Bani-G/Bani_BlueStampPortfolio/CraneRemote.pdf

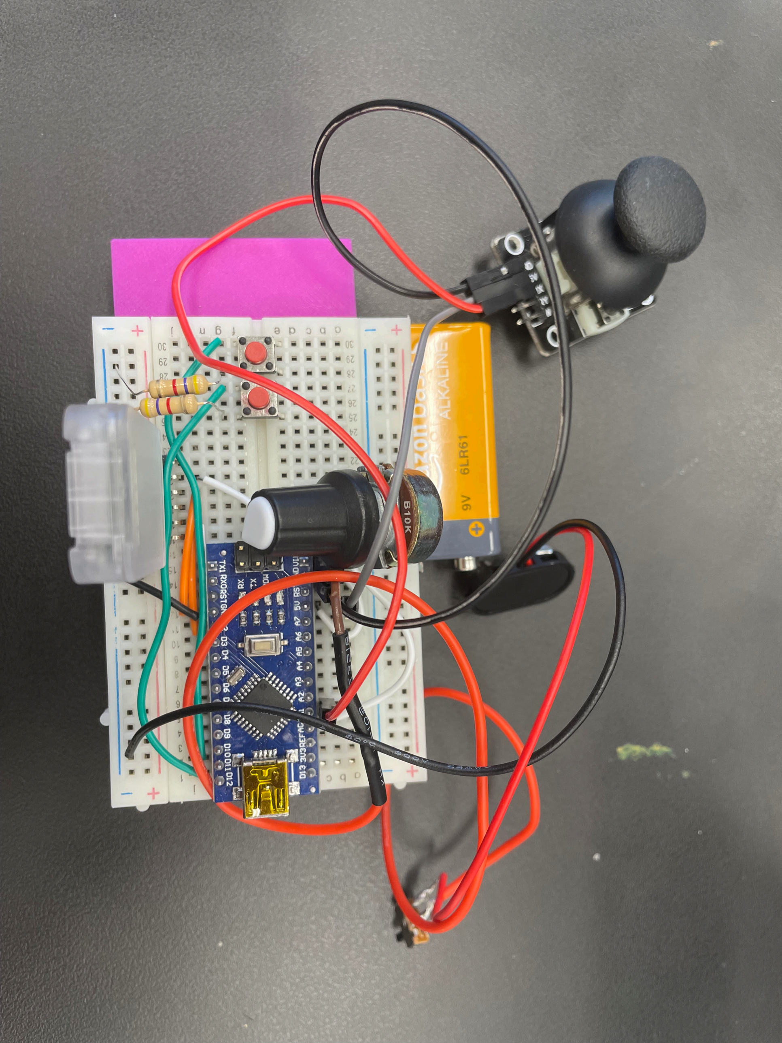
[picture p13: page 1]
