Bani-G/Bani_BlueStampPortfolio/CraneSchematics.png

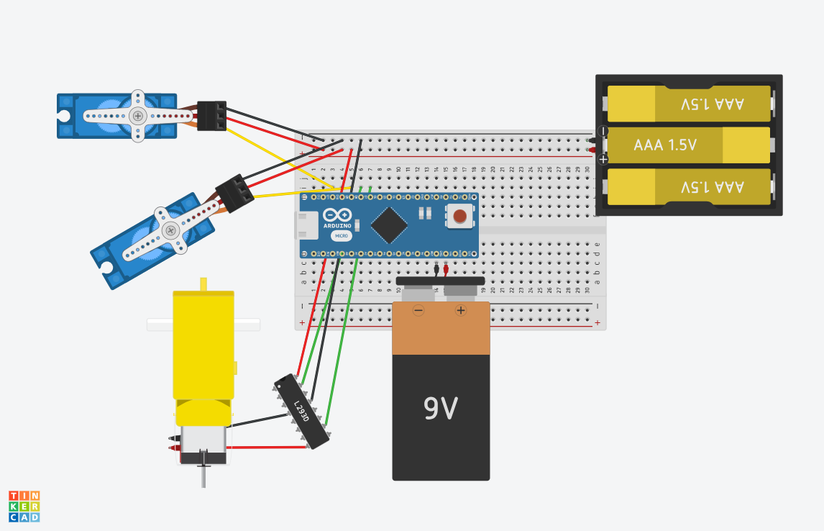
CraneSchematics.png
