Bani-G/Bani_BlueStampPortfolio/Flowchart.png

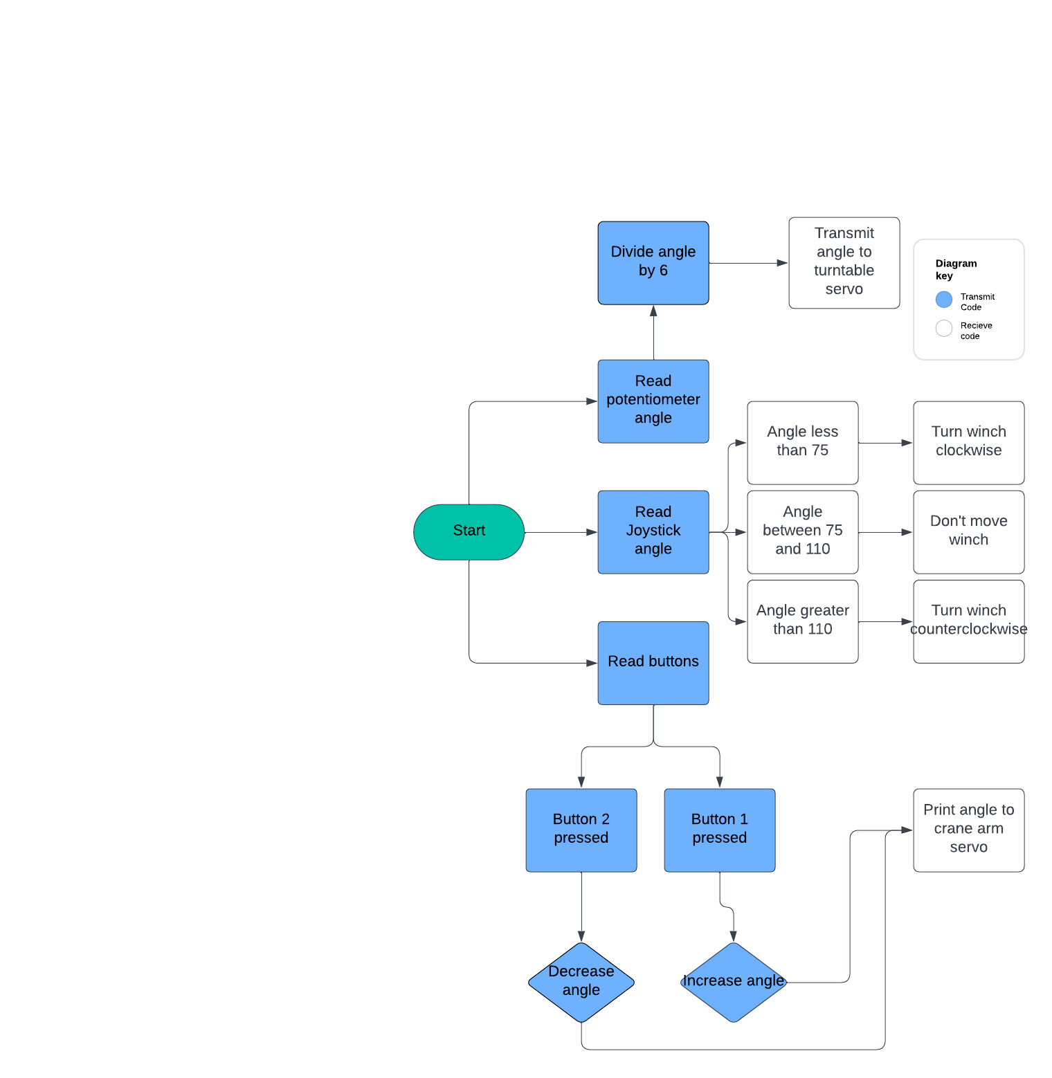
Flowchart.png
