Bani-G/Bani_BlueStampPortfolio/DCMotorMountV2.stl

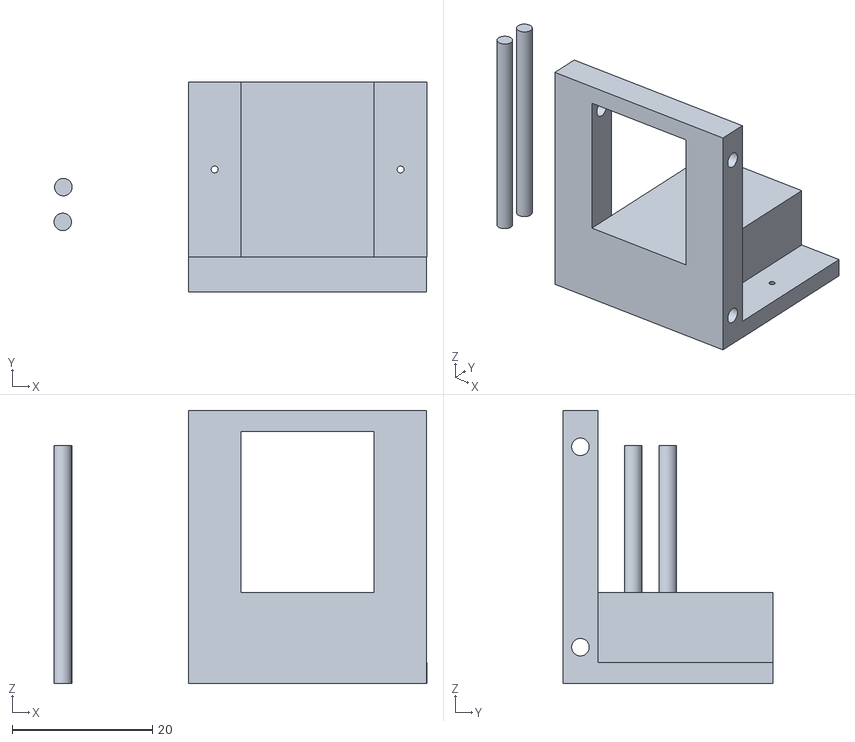
[picture p16: CAD file, 2024-07-19]
DCMotorMountV2.stl
53.2 x 30.0 x 39.0
