Bani-G/Bani_BlueStampPortfolio/FinalCraneMount.stl

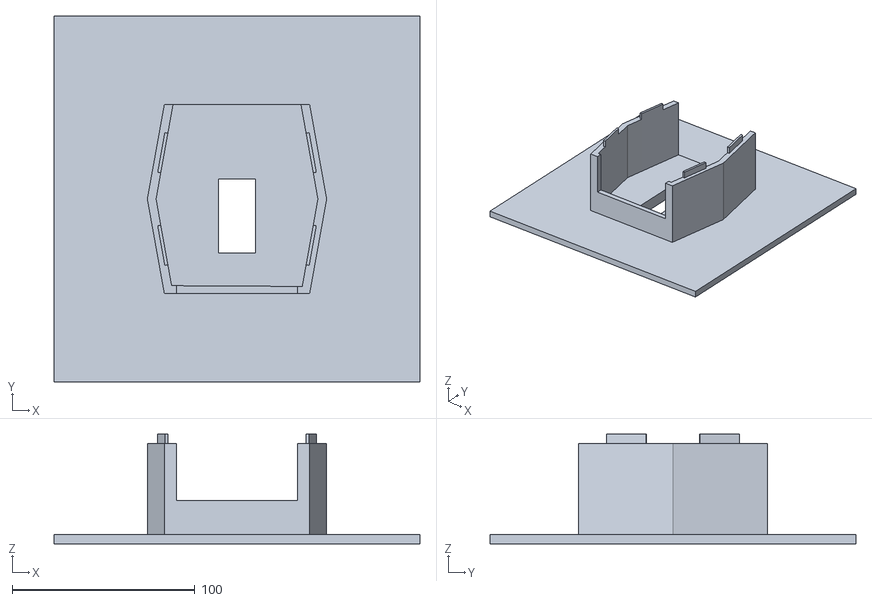
[picture p17: CAD file, 2024-07-19]
FinalCraneMount.stl
200.0 x 200.0 x 60.0
