Bani-G/Bani_BlueStampPortfolio/ServoMountV2.stl

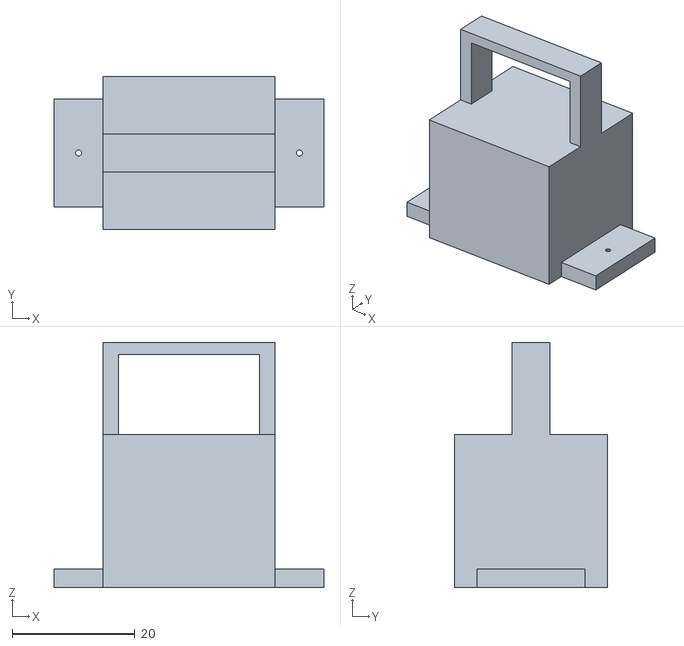
[picture p18: CAD file, 2024-07-19]
ServoMountV2.stl
44.1 x 25.0 x 40.0
