Bani-G/Bani_BlueStampPortfolio/DCMotorWinchV2.stl

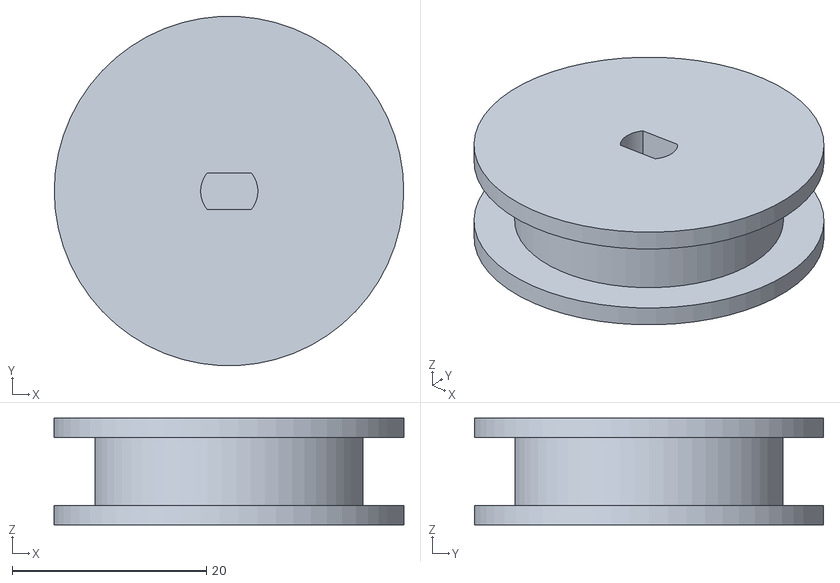
[picture p19: CAD file, 2024-07-19]
DCMotorWinchV2.stl
36.0 x 35.9 x 11.0
