Bani-G/Bani_BlueStampPortfolio/CraneArmV3.stl

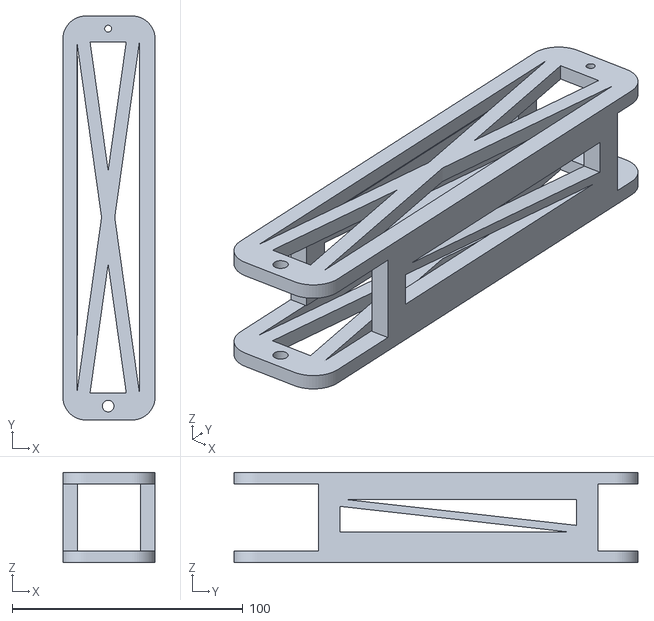
[picture p20: CAD file, 2024-07-18]
CraneArmV3.stl
40.0 x 175.0 x 39.0
