Bani-G/Bani_BlueStampPortfolio/(commit log)

2024-07-18 Rename Crane Schematics.png to CraneSchematics.png
2024-07-19 Rename Servo mount v2.stl to ServoMountV2.stl
    [ServoMountV2.stl]
2024-07-19 Rename DC motor winch v2.stl to DCMotorWinchV2.stl
    [DCMotorWinchV2.stl]
2024-07-19 Rename DC motor mount v2.stl to DCMotorMountV2.stl
    [DCMotorMountV2.stl]
2024-07-19 Rename Final crane mount.stl to FinalCraneMount.stl
    [FinalCraneMount.stl]
